Edzelf/ESP32Radio-V2/(list of files, drawings)

Other design files:
doc/ESP32-Radio.dip
