Edzelf/ESP32Radio-V2/(commit log)

2021-10-04 Add files via upload
    Experimental version.
    [ESP32-Radio.dip, example config.txt]
2021-10-25 Update example config.txt
    [example config.txt]
2023-03-24 Add files via upload
    Code clean-up
    [example config.ed.txt, example config.txt, radiopart.csv]
